koustav2502/Li-ion_BMS/XT60-M/XT60-M.step

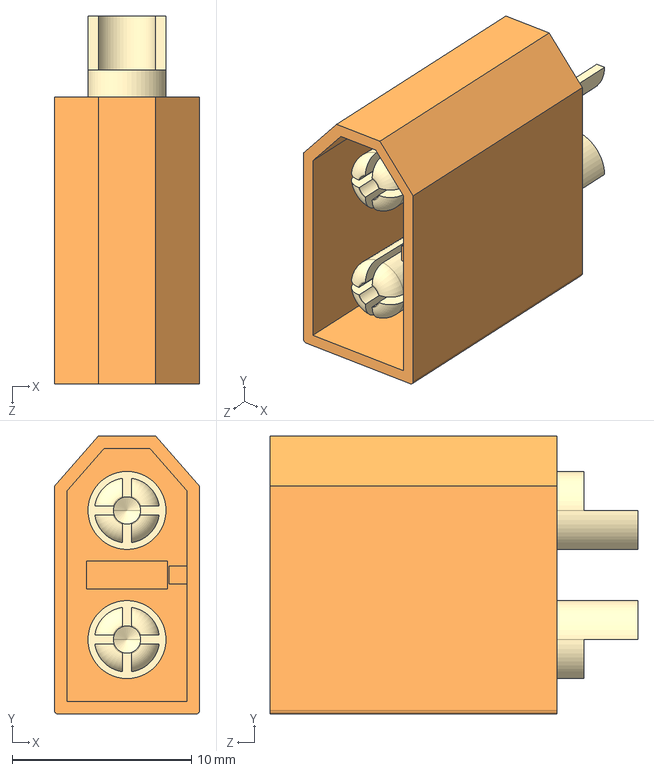
[picture p2: CAD file, 2026-10-29]
XT60-M/XT60-M.step
8.10 x 15.5 x 20.5 mm
