koustav2502/Li-ion_BMS/BQ24703PW/BQ24703PW.step

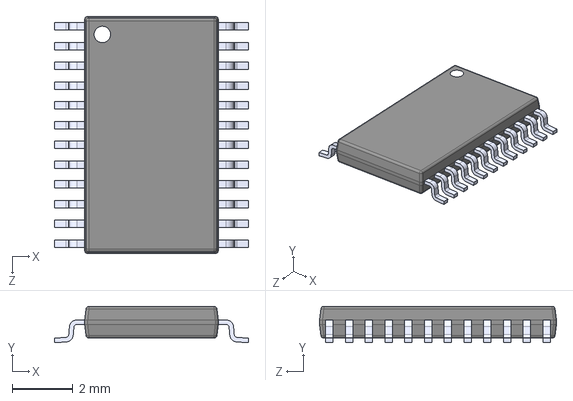
[picture p3: CAD file, 2026-10-29]
BQ24703PW/BQ24703PW.step
6.40 x 1.20 x 7.80 mm
