koustav2502/Li-ion_BMS/(list of files, drawings)

Other design files:
Li-ion_BMS.dsn
