koustav2502/Li-ion_BMS/Li-ion_BMS.kicad_pcb

## KiCad design Li-ion_BMS.kicad_pcb (2026-11-04)

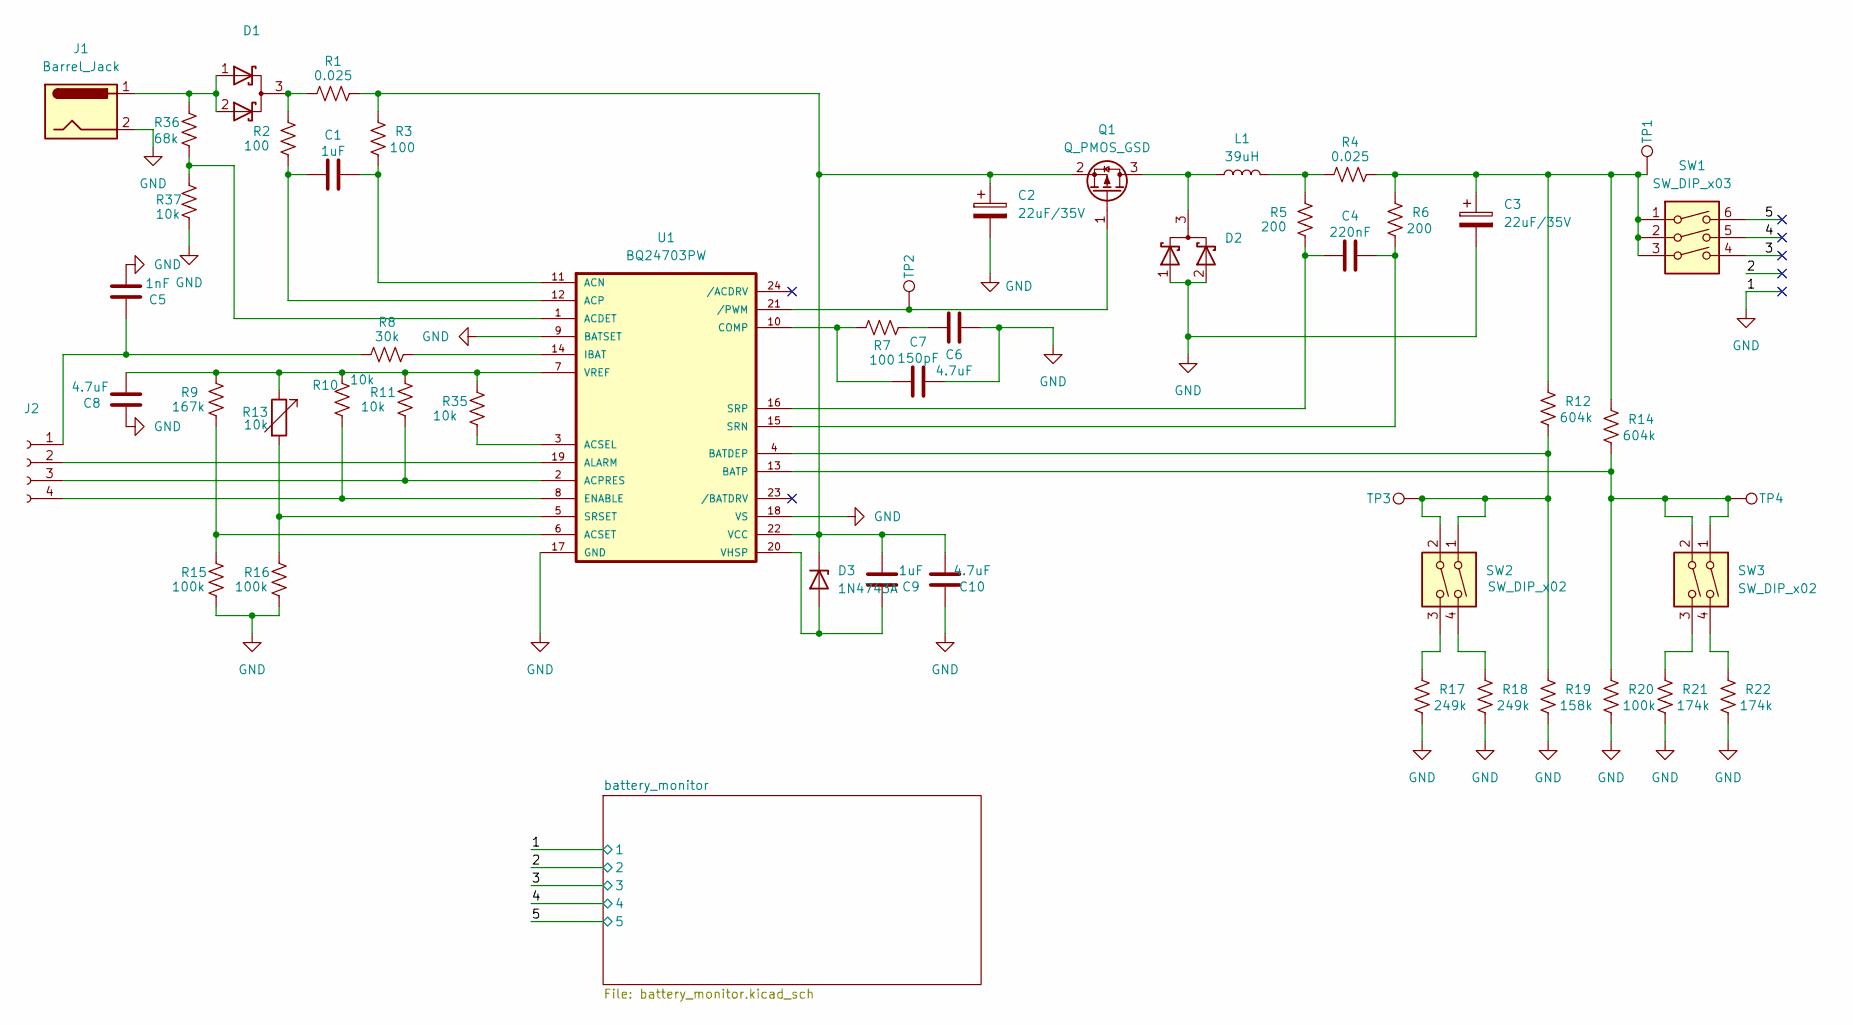
[picture p4: schematic Li-ion_BMS.kicad_sch, BQ24703]

Parts:
C1, C9: 1uF; C_Disc_D5.0mm_W2.5mm_P5.00mm
C2, C3: 22uF/35V; CP_Radial_D6.3mm_P2.50mm
C4: 220nF; C_Disc_D5.0mm_W2.5mm_P5.00mm
C5: 1nF; C_Disc_D3.0mm_W1.6mm_P2.50mm
C6, C8, C10: 4.7uF; C_Disc_D5.0mm_W2.5mm_P5.00mm
C7: 150pF; C_Disc_D3.0mm_W1.6mm_P2.50mm
D1, D2: DualSchottkyCommC; TO-220-3_Vertical
D3: 1N4743A; D_DO-41_SOD81_P10.16mm_Horizontal
J1: Barrel_Jack; BarrelJack_Horizontal
J2: Conn_01x04_Socket; PinHeader_1x05_P2.54mm_Vertical
L1: 39uH; L_Radial_D12.0mm_P10.00mm_Neosid_SD12k_style1
Q1: Q_PMOS_GSD; TO-220-3_Vertical
R1, R4: 0.025; R_Axial_DIN0411_L9.9mm_D3.6mm_P15.24mm_Horizontal
R2, R3, R7: 100; R_Axial_DIN0207_L6.3mm_D2.5mm_P10.16mm_Horizontal
R5, R6: 200; R_Axial_DIN0207_L6.3mm_D2.5mm_P10.16mm_Horizontal
R8: 30k; R_Axial_DIN0207_L6.3mm_D2.5mm_P10.16mm_Horizontal
R9: 167k; R_Axial_DIN0207_L6.3mm_D2.5mm_P10.16mm_Horizontal
R10, R11, R35, R37: 10k; R_Axial_DIN0207_L6.3mm_D2.5mm_P10.16mm_Horizontal
R12, R14: 604k; R_Axial_DIN0207_L6.3mm_D2.5mm_P10.16mm_Horizontal
R13: 10k; Potentiometer_Bourns_3296W_Vertical
R15, R16, R20: 100k; R_Axial_DIN0207_L6.3mm_D2.5mm_P10.16mm_Horizontal
R17, R18: 249k; R_Axial_DIN0207_L6.3mm_D2.5mm_P10.16mm_Horizontal
R19: 158k; R_Axial_DIN0207_L6.3mm_D2.5mm_P10.16mm_Horizontal
R21, R22: 174k; R_Axial_DIN0207_L6.3mm_D2.5mm_P10.16mm_Horizontal
R36: 68k; R_Axial_DIN0207_L6.3mm_D2.5mm_P10.16mm_Horizontal
SW1: SW_DIP_x03; SW_DIP_SPSTx03_Slide_9.78x9.8mm_W8.61mm_P2.54mm
SW2, SW3: SW_DIP_x02; SW_DIP_SPSTx02_Slide_9.78x7.26mm_W8.61mm_P2.54mm
TP1, TP2, TP3, TP4: TestPoint; TestPoint_THTPad_D2.0mm_Drill1.0mm
U1: BQ24703PW; TSSOP-24_4.4x7.8mm_P0.65mm

Connections:
/3: SW1.4; also elsewhere on the board
/4: SW1.5; also elsewhere on the board
/5: SW1.6; also elsewhere on the board
GND: C2.2, C3.2, C5.1, C6.2, C7.2, C8.2, C10.2, D2.1 (A), D2.2 (A), J1.2, R15.2, R16.2, R17.2, R18.2, R19.2, R20.2, R21.2, R22.2, R37.2, U1.9 (BATSET), U1.17 (GND), U1.18 (VS); also elsewhere on the board
unnamed: C3.1, R4.1, R6.1, R12.1, R14.1, SW1.1, SW1.2, SW1.3, TP1.1 (1_1)
unnamed: C6.1, R7.1
unnamed: D1.1 (A), D1.2 (A), J1.1, R36.1
unnamed: D1.3 (K), R1.2, R2.1
unnamed: D2.3 (K), L1.1, Q1.3 (D)
unnamed: C9.2, D3.2 (A), U1.20 (VHSP)
unnamed: C2.1, C9.1, C10.1, D3.1 (K), Q1.2 (S), R1.1, R3.1, U1.22 (VCC)
unnamed: C5.2, J2.1, R8.2
unnamed: J2.2, U1.19 (ALARM)
unnamed: J2.3, R11.2, U1.2 (ACPRES)
unnamed: J2.4, R10.2, U1.8 (ENABLE)
unnamed: L1.2, R4.2, R5.1
unnamed: Q1.1 (G), TP2.1 (1_1), U1.21 (/PWM)
unnamed: R17.1, SW2.3
unnamed: R18.1, SW2.4
unnamed: R21.1, SW3.3
unnamed: R22.1, SW3.4
unnamed: R36.2, R37.1, U1.1 (ACDET)
unnamed: C1.2, R3.2, U1.11 (ACN)
unnamed: C1.1, R2.2, U1.12 (ACP)
unnamed: R35.2, U1.3 (ACSEL)
unnamed: R9.2, R15.1, U1.6 (ACSET)
unnamed: R12.2, R19.1, SW2.1, SW2.2, TP3.1 (1_1), U1.4 (BATDEP)
unnamed: R14.2, R20.1, SW3.1, SW3.2, TP4.1 (1_1), U1.13 (BATP)
unnamed: C7.1, R7.2, U1.10 (COMP)
unnamed: R8.1, U1.14 (IBAT)
unnamed: C4.2, R6.2, U1.15 (SRN)
unnamed: C4.1, R5.2, U1.16 (SRP)
unnamed: R13.2, R16.1, U1.5 (SRSET)
unnamed: C8.1, R9.1, R10.1, R11.1, R13.1, R35.1, U1.7 (VREF)

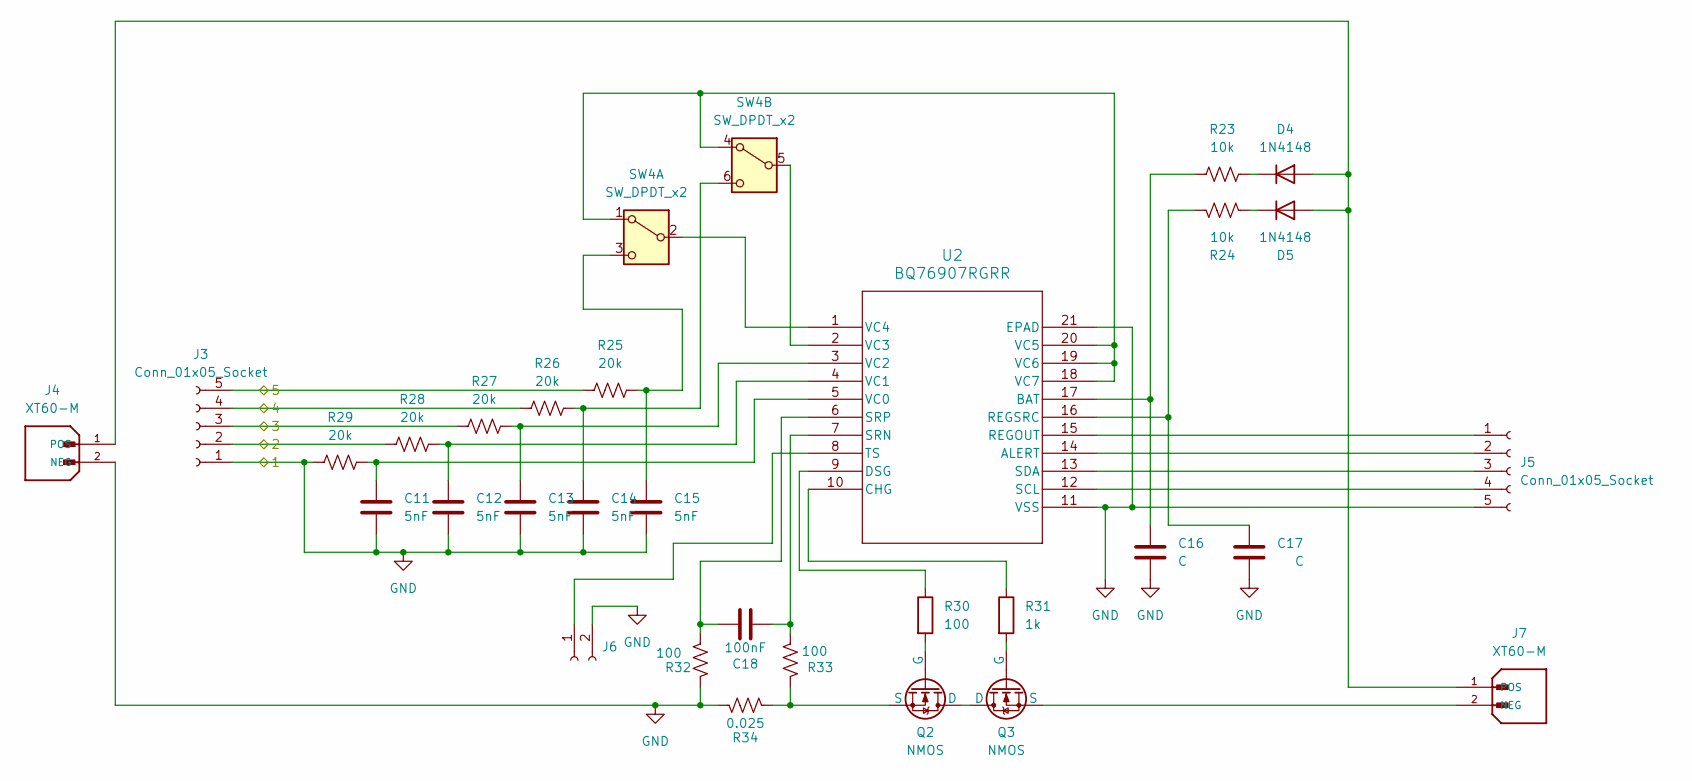
[picture p5: schematic battery_monitor.kicad_sch]

Parts:
C11, C12, C13, C14, C15: 5nF; C_Disc_D3.0mm_W1.6mm_P2.50mm
C16, C17: C; C_Disc_D5.0mm_W2.5mm_P5.00mm
C18: 100nF; C_Disc_D5.0mm_W2.5mm_P5.00mm
D4, D5: 1N4148; D_DO-35_SOD27_P7.62mm_Horizontal
J3: Conn_01x05_Socket; JST_XH_B5B-XH-A_1x05_P2.50mm_Vertical
J4, J7: XT60-M; AMASS_XT60-M_1x02_P7.20mm_Vertical; PARTREV V1.2
J5: Conn_01x05_Socket; PinHeader_1x05_P2.54mm_Vertical
J6: Conn_01x02_Socket; JST_XH_B2B-XH-A_1x02_P2.50mm_Vertical
Q2, Q3: NMOS; TO-220-3_Vertical
R23, R24: 10k; R_Axial_DIN0207_L6.3mm_D2.5mm_P10.16mm_Horizontal
R25, R26, R27, R28, R29: 20k; R_Axial_DIN0207_L6.3mm_D2.5mm_P10.16mm_Horizontal
R30, R32, R33: 100; R_Axial_DIN0207_L6.3mm_D2.5mm_P10.16mm_Horizontal
R31: 1k; R_Axial_DIN0207_L6.3mm_D2.5mm_P10.16mm_Horizontal
R34: 0.025; R_Axial_DIN0614_L14.3mm_D5.7mm_P20.32mm_Horizontal
SW4: SW_DPDT_x2; SW_DIP_SPSTx03_Slide_9.78x9.8mm_W8.61mm_P2.54mm
U2: BQ76907RGRR; QFN-20-1EP_3.5x3.5mm_P0.5mm_EP2x2mm

Connections:
/2: J3.2, R28.2
/3: J3.3, R27.2; also elsewhere on the board
/4: J3.4, R26.2; also elsewhere on the board
/5: J3.5, R25.2; also elsewhere on the board
GND: C11.2, C12.2, C13.2, C14.2, C15.2, C16.2, C17.2, J3.1, J4.2 (NEG), J5.5, J6.2, R29.2, R32.1, R34.2, U2.11 (VSS), U2.21 (EPAD); also elsewhere on the board
unnamed: D4.2 (A), D5.2 (A), J4.1 (POS), J7.1 (POS)
unnamed: D4.1 (K), R23.1
unnamed: D5.1 (K), R24.1
unnamed: J5.1, U2.15 (REGOUT)
unnamed: J5.2, U2.14 (ALERT)
unnamed: J5.3, U2.13 (SDA)
unnamed: J5.4, U2.12 (SCL)
unnamed: J6.1, U2.8 (TS)
unnamed: J7.2 (NEG), Q3.3 (S)
unnamed: Q2.1 (D), Q3.1 (D)
unnamed: Q2.2 (G), R30.2
unnamed: Q2.3 (S), R33.1, R34.1
unnamed: Q3.2 (G), R31.2
unnamed: SW4.1 (A), SW4.4 (A), U2.18 (VC7), U2.19 (VC6), U2.20 (VC5)
unnamed: SW4.2 (B), U2.1 (VC4)
unnamed: C15.1, R25.1, SW4.3 (C)
unnamed: SW4.5 (B), U2.2 (VC3)
unnamed: C14.1, R26.1, SW4.6 (C)
unnamed: C16.1, R23.2, U2.17 (BAT)
unnamed: R31.1, U2.10 (CHG)
unnamed: R30.1, U2.9 (DSG)
unnamed: C17.1, R24.2, U2.16 (REGSRC)
unnamed: C18.2, R33.2, U2.7 (SRN)
unnamed: C18.1, R32.2, U2.6 (SRP)
unnamed: C11.1, R29.1, U2.5 (VC0)
unnamed: C12.1, R28.1, U2.4 (VC1)
unnamed: C13.1, R27.1, U2.3 (VC2)

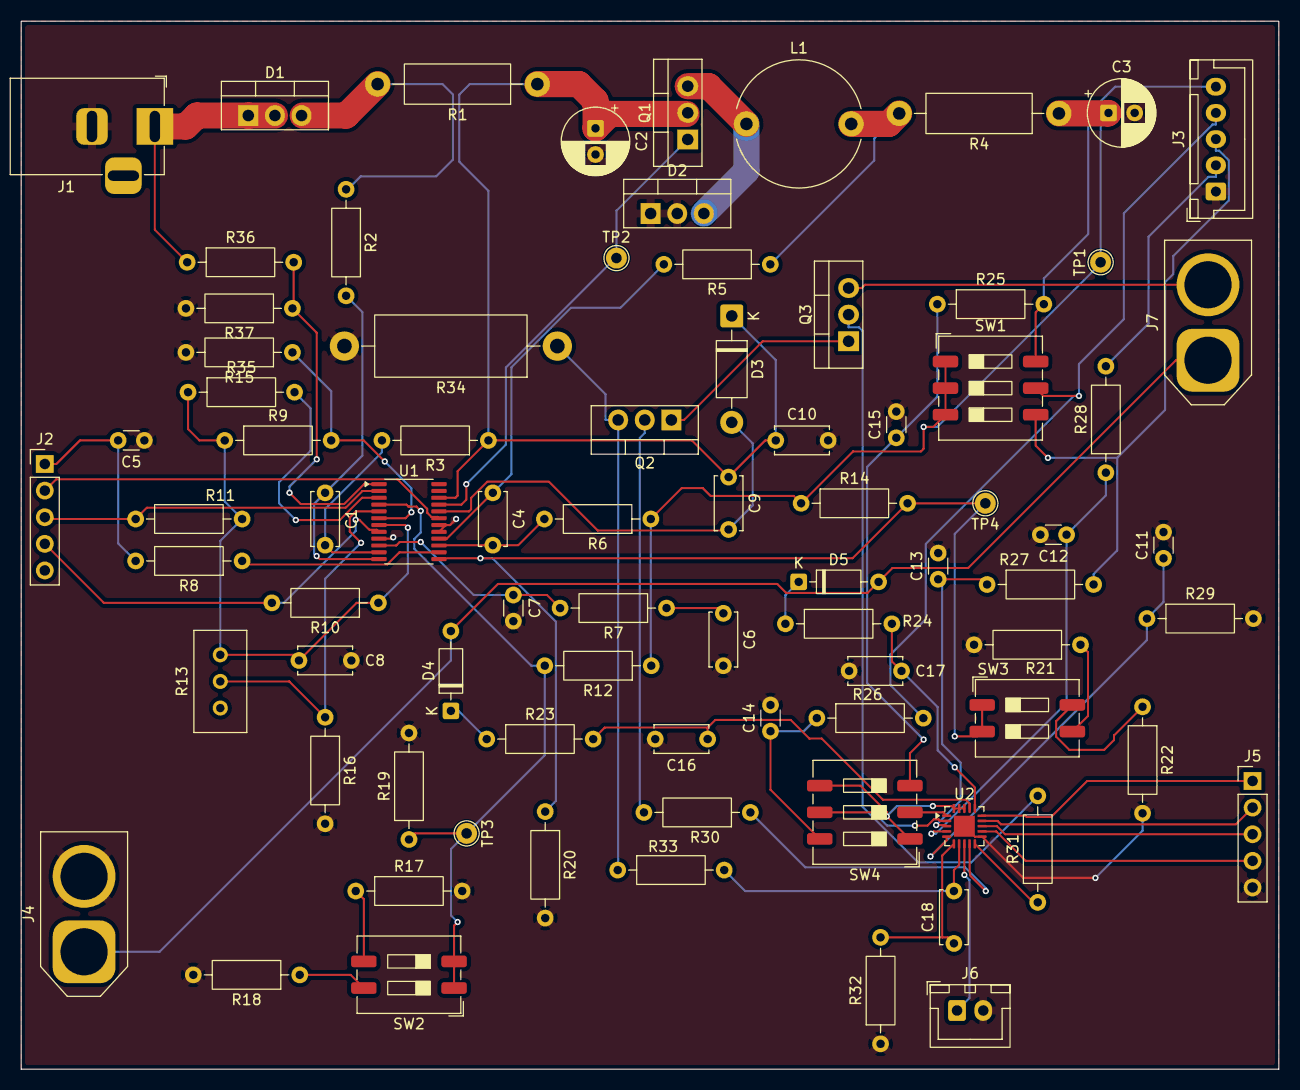
[picture p6: board Li-ion_BMS.kicad_pcb from above]

Board: 2 copper layers, 120.0 x 100.0 mm, 81 parts (0 on the bottom side), 62 nets.
