koustav2502/Li-ion_BMS/(commit log)

2026-10-29 Initial commit of BMS
    [BQ24703PW.step, Li-ion_BMS.kicad_pcb, Li-ion_BMS.kicad_sch, XT60-M.step, battery_monitor.kicad_sch, untitled.kicad_sch]
2026-11-02 floorplan v2
    [Li-ion_BMS.kicad_pcb, Li-ion_BMS.kicad_sch, battery_monitor.kicad_sch]
2026-11-03 layout done
    [Li-ion_BMS.dsn, Li-ion_BMS.kicad_pcb, Li-ion_BMS.kicad_sch, battery_monitor.kicad_sch, untitled.kicad_sch]
2026-11-04 layout updated
    [Li-ion_BMS.kicad_pcb, Li-ion_BMS.kicad_sch]
